Sudo-Guts/VoxID/DOC/CheckList.txt

==========================================================================
VOXID | Seguimiento de etapas
==========================================================================

[x] Confirmar plataforma digital: Ophyra, STM32F407VGT6 y TFT ST7735.
[x] Implementar DSP portable: Frame, Hamming, FFT, potencia, Mel, log-Mel y DCT.
[x] Integrar los ocho modulos compartidos sin duplicarlos en el firmware.
[x] Conservar el benchmark sintetico en voxid_test y sus dependencias.
[x] Implementar la autoprueba sintetica de 720 muestras y tres frames.
[x] Unificar parametros digitales en voxid_config.h.
[x] Normalizar el codigo propio: ASCII, cuatro espacios y firmas en una linea.
[x] Documentar APIs propias y conservar bloques USER CODE del firmware generado.
[x] Corregir recorte GFX con coordenadas negativas y probarlo sobre memoria.
[x] Corregir Makefile: dependencias DSP, seleccion de prueba y ejecucion completa.
[x] Excluir resultados generados de C0DE/out y conservar .gitkeep.

==========================================================================
ETAPA 1 | ADC1 + TIM2 + DMA e interfaz
==========================================================================

[x] Configurar PA2, ADC1 de 12 bits, TIM2 TRGO a 16 kHz y DMA circular.
[x] Capturar 48000 muestras en 75 mitades de 640 muestras.
[x] Mantener el procesamiento fuera de las interrupciones.
[x] Rechazar capturas con bloques sobrescritos o errores HAL.
[x] Detener ADC y DMA desde el bucle principal tambien tras un error de IRQ.
[x] Animar circulos solo en PREPARADO; fijarlos durante la captura.
[x] Corregir repeticion desde RESULTADO/ERROR y reiniciar cuenta regresiva.
[x] Mostrar solo BACK y bloquear UP/DN/OK desde la solicitud de captura.
[x] Probar el cambio entre tomas cuando ADC conserva READY de la anterior.
[x] Probar estos contratos en PC con HAL y dibujo simulados.
[ ] Clean/Build Debug con toolchain ARM en STM32CubeIDE.
[ ] Validar temporizacion, ADC, DMA, botones e interfaz en la placa.

==========================================================================
ETAPA 2 | PCM y MFCC de audio real
==========================================================================

[x] Convertir ADC sin signo a PCM de 16 bits y eliminar DC.
[x] Evitar el transitorio inicial de un nivel DC constante.
[x] Exigir 48000 muestras y 298 frames MFCC con coeficientes finitos.
[x] Separar frames totales de frames seleccionados por energia.
[x] Calcular la media solo con los frames seleccionados.
[x] No mostrar grafica de voz cuando no se seleccionaron frames.
[x] Probar silencio, offset DC, senal debil, tono e intermitencia en PC.
[x] Probar reinicio, cancelacion, fallos de ADC/DMA y repeticion.
[ ] Calibrar el umbral RMS con ruido y voz de la etapa analogica real.
[ ] Confirmar ausencia de perdida de bloques con DSP y TFT activos.
[ ] Verificar capturas repetibles de MARIPOSA en Ophyra.

==========================================================================
ETAPA 3 | Tres prototipos MFCC por locutor
==========================================================================

[x] Definir aceptacion inicial: continuidad, MFCC finitos y 20 frames seleccionados.
[x] Registrar tres medias MFCC de tomas independientes por locutor en RAM.
[x] Repetir tomas insuficientes o fallidas sin avanzar el contador.
[x] Conservar el perfil previo hasta aceptar tres tomas de reemplazo.
[x] Cancelar el registro pendiente sin borrar perfiles completos.
[x] Probar modulo de registro y flujo UI con ADC/DMA simulados.
[ ] Compilar la nueva version con toolchain ARM en STM32CubeIDE.
[ ] Validar registro, cancelacion y regrabacion en Ophyra.
[ ] Ajustar el minimo de frames con varias personas y nuevas tomas.

==========================================================================
ETAPA 4 | EEPROM M24C32 e identificacion
==========================================================================

[ ] Definir registros, version y validacion de perfiles.
[ ] Implementar acceso M24C32 y persistencia de prototipos.
[ ] Implementar distancia normalizada y criterio de rechazo.
[ ] Validar identificacion con tomas distintas de las usadas en registro.

==========================================================================
HARDWARE Y SIMULACIONES | Rama pcb-sim
==========================================================================

[ ] Integrar la revision de simulaciones con valores de la PCB vigente.
[ ] Ejecutar de nuevo AC, Monte Carlo y ruido con esos valores.
[ ] Verificar ERC/DRC y correspondencia de archivos de fabricacion.
[ ] Medir alimentaciones, offset y limites reales antes del acoplamiento ADC.
