Sudo-Guts/VoxID/PCB/Microfono.kicad_pcb

## KiCad design PCB/Microfono.kicad_pcb (2026-10-16)

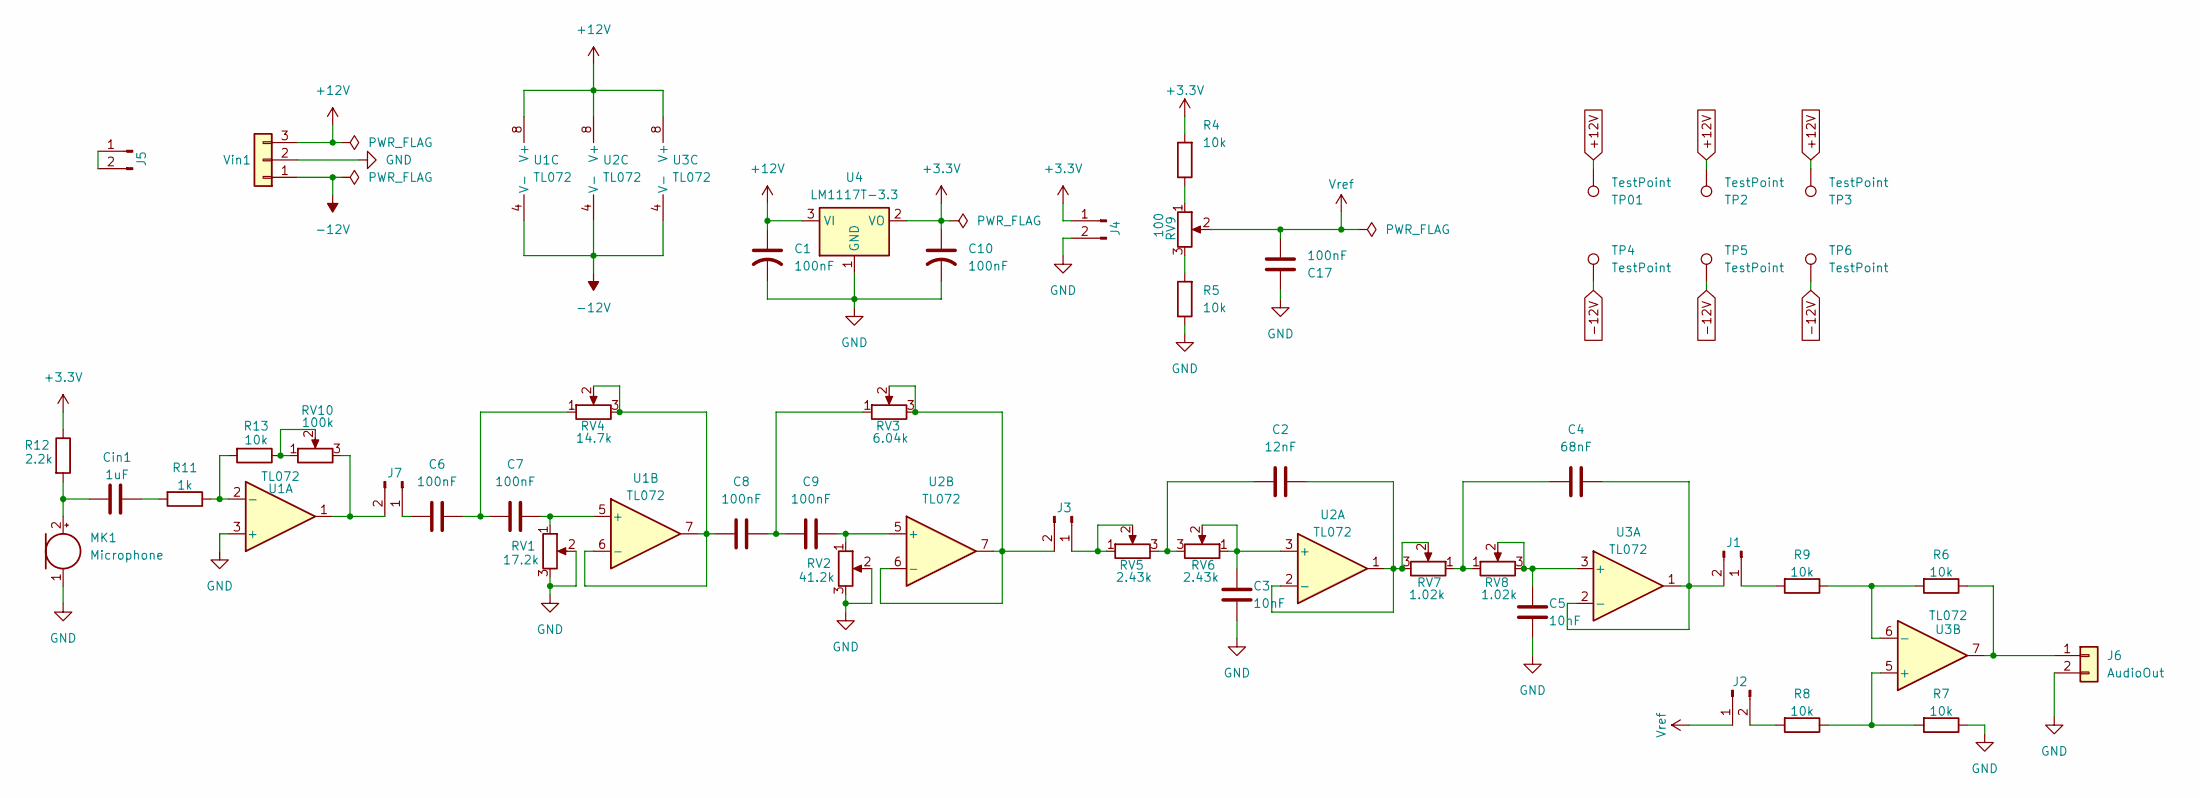
[picture p1: schematic Microfono.kicad_sch]

Parts:
C1, C6, C7, C8, C9, C10, C17: 100nF; CP_Radial_Tantal_D5.0mm_P5.00mm
C2: 12nF; CP_Radial_Tantal_D5.0mm_P5.00mm
C3, C5: 10nF; CP_Radial_Tantal_D5.0mm_P5.00mm
C4: 68nF; CP_Radial_Tantal_D5.0mm_P5.00mm
Cin1: 1uF; CP_Radial_Tantal_D5.0mm_P5.00mm
J1, J2, J3, J7: Conn_01x02_Pin; PinHeader_1x02_P2.54mm_Vertical
J4, J5: v3.3; PinHeader_1x02_P2.54mm_Vertical
J6: AudioOut; TerminalBlock_MaiXu_MX126-5.0-02P_1x02_P5.00mm
MK1: Microphone; POM-2244P-C3310-2-R
R4, R5, R6, R7, R8, R9, R13: 10k; R_Axial_DIN0309_L9.0mm_D3.2mm_P12.70mm_Horizontal
R11: 1k; R_Axial_DIN0309_L9.0mm_D3.2mm_P12.70mm_Horizontal
R12: 2.2k; R_Axial_DIN0309_L9.0mm_D3.2mm_P12.70mm_Horizontal
RV1: 17.2k; Potentiometer_Bourns_3296W_Vertical
RV2: 41.2k; Potentiometer_Bourns_3296W_Vertical
RV3: 6.04k; Potentiometer_Bourns_3296W_Vertical
RV4: 14.7k; Potentiometer_Bourns_3296W_Vertical
RV5, RV6: 2.43k; Potentiometer_Bourns_3296W_Vertical
RV7, RV8: 1.02k; Potentiometer_Bourns_3296W_Vertical
RV9: 100; Potentiometer_Bourns_3296W_Vertical
RV10: 100k; Potentiometer_Bourns_3296W_Vertical
TP01, TP2, TP3, TP4, TP5, TP6: TestPoint; TestPoint_Bridge_Pitch7.62mm_Drill1.3mm
U1, U2, U3: TL072; DIP-8_W7.62mm_Socket
U4: LM1117T-3.3; TO-220-3_Vertical
Vin1: Conn_01x03; TerminalBlock_MaiXu_MX126-5.0-03P_1x03_P5.00mm

Connections:
+3.3V: C10.1, J4.1 (Pin_1_1), R4.2, R12.1, U4.2 (VO)
+12V: C1.1, TP01.1 (1_1), TP2.1 (1_1), TP3.1 (1_1), U1.8 (V+), U2.8 (V+), U3.8 (V+), U4.3 (VI), Vin1.3
-12V: TP4.1 (1_1), TP5.1 (1_1), TP6.1 (1_1), U1.4 (V-), U2.4 (V-), U3.4 (V-), Vin1.1
unnamed: C2.1, RV5.3, RV6.3
unnamed: C4.1, RV7.1, RV8.1
unnamed: C6.2, C7.1, RV4.1
unnamed: C8.2, C9.1, RV3.1
unnamed: Cin1.2, R11.2
unnamed: J1.1, R9.2
unnamed: C4.2, J1.2, U3.1, U3.2 (-)
unnamed: J2.2, R8.2
unnamed: J3.1, RV5.1, RV5.2
unnamed: J3.2, RV3.2, RV3.3, U2.6 (-), U2.7
unnamed: J5.1, J5.2
unnamed: J6.1 (Pin_1_1), R6.1, U3.7
unnamed: C6.1, J7.1
unnamed: J7.2, RV10.3, U1.1
unnamed: Cin1.1, MK1.2 (+_2), R12.2
unnamed: R4.1, RV9.1
unnamed: R5.2, RV9.3
unnamed: R13.1, RV10.1, RV10.2
unnamed: R11.1, R13.2, U1.2 (-)
unnamed: C7.2, RV1.1 (1_1), U1.5 (+)
unnamed: C8.1, RV4.2, RV4.3, U1.6 (-), U1.7
unnamed: C3.1, RV6.1, RV6.2, U2.3 (+)
unnamed: C2.2, RV7.2, RV7.3, U2.1, U2.2 (-)
unnamed: C9.2, RV2.1 (1_1), U2.5 (+)
unnamed: C5.1, RV8.2, RV8.3, U3.3 (+)
unnamed: R7.2, R8.1, U3.5 (+)
unnamed: R6.2, R9.1, U3.6 (-)
Vref: C17.1, J2.1, RV9.2

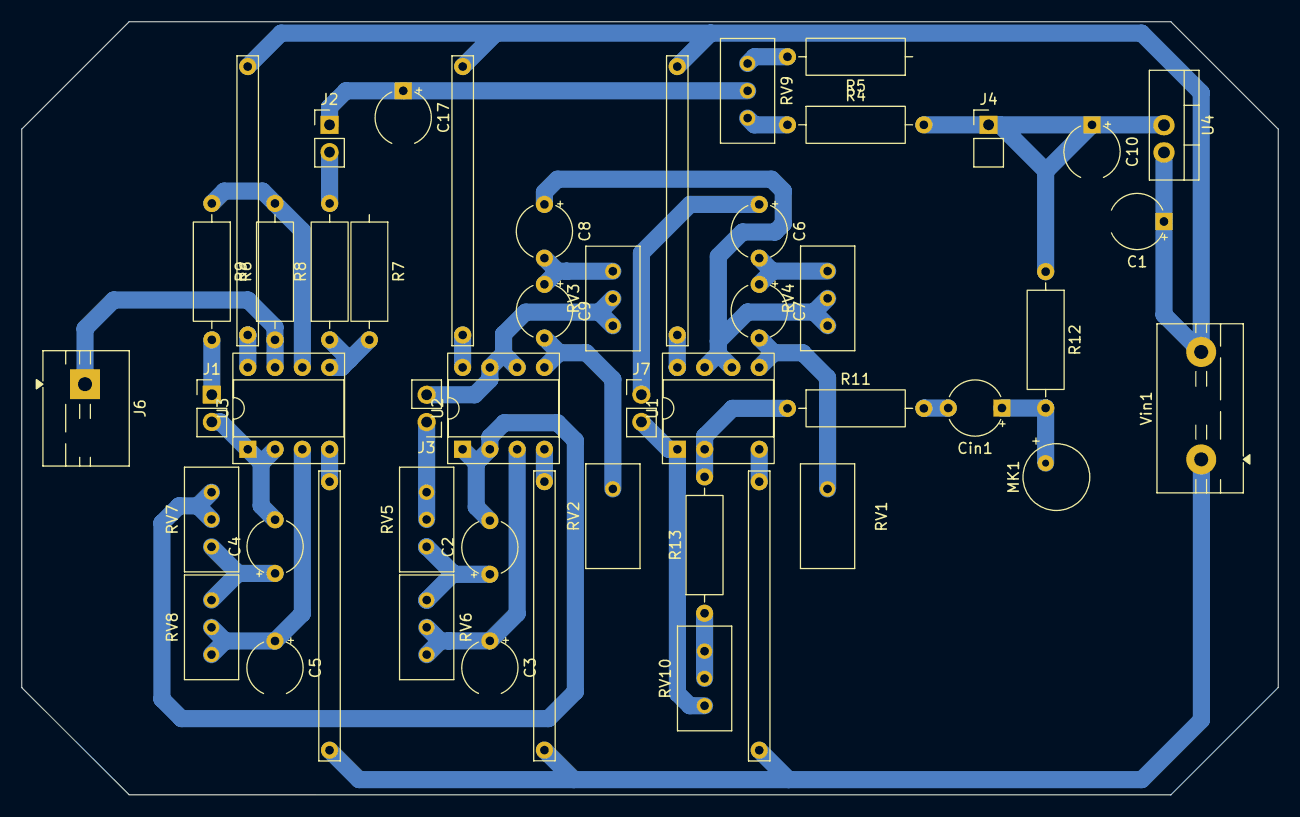
[picture p2: board Microfono.kicad_pcb from above]

Board: 2 copper layers, 117.0 x 72.0 mm, 49 parts (0 on the bottom side), 30 nets.
