Sudo-Guts/VoxID/C0DE/ophyra/voxid/Core/Src/main.c

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
/* Includes ------------------------------------------------------------------*/
#include "main.h"

/* USER CODE BEGIN Includes */
#include "st7735.h"
#include "buttons.h"
#include "ui.h"
#include "voxid_dsp.h"
#include "voxid_audio.h"
#include "voxid_storage.h"

/* USER CODE END Includes */

ADC_HandleTypeDef hadc1;
DMA_HandleTypeDef hdma_adc1;

I2C_HandleTypeDef hi2c1;

SPI_HandleTypeDef hspi1;

TIM_HandleTypeDef htim2;

/* USER CODE BEGIN PV */
static volatile bool ui_ready = false;
/* USER CODE END PV */

void SystemClock_Config(void);
static void MX_GPIO_Init(void);
static void MX_DMA_Init(void);
static void MX_ADC1_Init(void);
static void MX_I2C1_Init(void);
static void MX_SPI1_Init(void);
static void MX_TIM2_Init(void);
/**
  * @brief  The application entry point.
  * @retval int
  */
int main(void)
{

  /* MCU Configuration--------------------------------------------------------*/

  /* Reset of all peripherals, Initializes the Flash interface and the Systick. */
  HAL_Init();

  /* Configure the system clock */
  SystemClock_Config();

  /* Initialize all configured peripherals */
  MX_GPIO_Init();
  MX_DMA_Init();
  MX_ADC1_Init();
  MX_SPI1_Init();
  MX_TIM2_Init();
  MX_I2C1_Init();

  /* USER CODE BEGIN 2 */

  buttons_init();

  // Preparar el pipeline MFCC antes de capturar muestras reales.
  (void)voxid_dsp_init();

  // Cargar lo recuperable; LOCUTORES informa los fallos de lectura.
  (void)voxid_storage_init(&hi2c1);

  ui_ready = st7735_init(&hspi1);

  if (ui_ready) {
      ui_ready = ui_init();
  }

    /* USER CODE END 2 */

  /* Infinite loop */
  /* USER CODE BEGIN WHILE */
  while (1)
  {
    /* USER CODE END WHILE */

    /* USER CODE BEGIN 3 */

    if (ui_ready) {
        voxid_audio_task();
        ui_task();
        HAL_Delay(voxid_audio_status() == VOXID_AUDIO_CAPTURING ? 1U : 5U);
    } else {
        HAL_Delay(100U);
    }
  }
  /* USER CODE END 3 */
}

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
/* USER CODE BEGIN 4 */

void HAL_GPIO_EXTI_Callback(uint16_t GPIO_Pin)
{
    buttons_on_exti(GPIO_Pin, HAL_GetTick());
}


/* USER CODE END 4 */
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
