Sudo-Guts/VoxID/C0DE/ophyra/voxid/voxid.ioc

Mcu.UserName=STM32F407VGTx
PA15.GPIO_Label=SPI_CS
PA15.Signal=GPIO_Output
PA2.Signal=ADCx_IN2
PA7.GPIO_Label=TFT_BckLight
PA7.Signal=GPIO_Output
PB3.Signal=SPI1_SCK
PB5.Signal=SPI1_MOSI
PC2.GPIO_Label=BTN_UP
PC2.Signal=GPXTI2
PD3.GPIO_Label=BTN_BACK
PD3.Signal=GPXTI3
PD4.GPIO_Label=BTN_OK
PD4.Signal=GPXTI4
PD5.GPIO_Label=BTN_DOWN
PD5.Signal=GPXTI5
PD6.GPIO_Label=TFT_RS
PD6.Signal=GPIO_Output
PD7.GPIO_Label=TFT_Reset
PD7.Signal=GPIO_Output
PH0-OSC_IN.Signal=RCC_OSC_IN
PH1-OSC_OUT.Signal=RCC_OSC_OUT
