Sudo-Guts/VoxID/(commit log)

2026-10-18 build: Configurar compilacion inicial de VoxID en Windows
2026-10-19 build: Agregar sistema de pruebas generico y limpieza automatica
2026-10-19 feat: Implementar modulo de segmentacion de audio
2026-10-19 docs: Organizar avances y tareas pendientes de C0DE
2026-10-19 feat: Implementar modulo de enventanado de audio
2026-10-20 wip: Actualizacion de PCB y simulaciones
2026-10-20 sim: Organizar archivos de simulación PSIM y LTspice
2026-10-21 feat: Implementar FFT Radix-2 con factores de rotacion
2026-10-21 feat: Actualizar diseño PCB y agregar diagrama del sistema
2026-10-21 test: Agregar pruebas unitarias de FFT Radix-2
2026-10-22 pcb: Sustituir potenciometros por resistencias fijas comerciales
2026-10-22 feat: Implementar modulo de espectro de potencia
2026-10-22 feat: Implementar banco de filtros Mel
2026-10-22 feat: Implementar transformacion logaritmica de energias Mel
2026-10-22 feat: Integrar cadena de extraccion MFCC
2026-10-22 pcb: Incluir proteccion del ADC
2026-10-22 pcb: enrutado
2026-10-23 pcb: Creacion de geber para cnc
2026-10-23 pcb: Pcb lista :)
2026-10-23 chore(ophyra): Configurar ADC1 y TIM2 para muestreo a 16 kHz, y spi1 para la TFT
2026-10-23 feat(ophyra): Implementar eventos EXTI y antirrebote de botones
2026-10-23 feat(ophyra): Crear interfaz TFT horizontal con maquina de estados
2026-10-23 built: Creacion de proyecto voxid_test
2026-10-23 Integracion de codigo C
    built: Creacion del codigo C base, para el procesamiento de voz
2026-10-26 feat(tft): implementar controlador ST7735 con HAL SPI
2026-10-26 refactor(tft): unificar API gfx y normalizar estilo de librerias
2026-10-26 feat(gfx): Agregar implementacion de graficos en la TFT
2026-10-26 feat(ui): migrar interfaz Ophyra a gfx y retirar driver INTESC
2026-10-26 chore(tft): conservar archivo base de VoxID y limpiar preferencias IDE
2026-10-26 build(stm32): agregar ruta DSP compartida en Debug y Release
2026-10-26 style(ui): Actualizar interfaz grafica de VoxID
2026-10-26 feat(ui): agregar autoprueba MFCC y pantallas preparatorias de locutor
    Validar 720 muestras sinteticas, tres frames MFCC y coeficientes finitos desde Diagnostico. Preparar flujos de identificar y registrar sin afirmar adquisicion real.
2026-10-27 feat(ui): mini botones de navegacion y graficas de prueba MFCC
    Distribuir UP/DN/OK/BACK como indicadores de pulsadores fisicos y agregar vistas de forma de onda PCM y barras de 13 MFCC, conservando resumen y coeficientes numericos.
2026-10-27 style(ui): simplificar prueba MFCC y footer contextual
    Eliminar vista de onda sintetica y leyenda de signos, alinear campos del resumen en dos columnas y ocultar etiquetas de botones inactivos. Conservar grafica de MFCC y prueba numerica.
2026-10-27 feat(audio): habilitar captura corta ADC1 con disparos TIM2 a 16 kHz
    Agregar captura finita de 720 muestras mediante IRQ EOC, comprobaciones de min/max/promedio y control de inicio/parada desde la UI. Dejar DMA y PCM/MFCC de audio real para la siguiente fase.
2026-10-27 feat(ui): animar circulos concentricos pastel durante captura ADC
    Crear modulo grafico reutilizable ui_voice sin bloqueos, con tres anillos en fondo claro y redibujado acotado. Mantener estadisticas de ADC y preparar estados de voz futuros.
2026-10-27 feat(audio): capturar MARIPOSA durante 3s con ADC1 TIM2 DMA
    Configurar DMA2 Stream0 CH0 circular y solicitudes ADC continuas, consumir bloques de 640 muestras sin procesar en IRQ y detenerse tras 48000 muestras. Integrar cuenta regresiva con circulos pastel y verificacion de MIN MAX PROMEDIO; preservar MFCC sintetico.
2026-10-27 fix(audio): evitar detener DMA si ADC no tiene handle vinculado
    Validar configuracion antes de invocar HAL_ADC_Stop_DMA y proteger la salida al cancelar una captura con perifericos sin vincular.
2026-10-27 fix(ui): detener animacion en resultados y ocultar OK durante escucha
    Separar vistas PREPARADO, ESCUCHANDO y RESULTADO/ERROR; mantener BACK habilitado durante DMA, permitir OK solo antes/despues y limpiar el area de circulos al concluir captura.
2026-10-27 perf(ui): animar circulos solo antes de iniciar la captura
    Mantener fase fija durante ADC/DMA y actualizar solo cuenta regresiva; conservar circulos animados en PREPARADO y ocultarlos en RESULTADO/ERROR.
2026-10-27 feat(dsp): procesar PCM y MFCC reales desde ADC DMA en 3 s
    Agregar voxid_voice para conversion ADC->PCM con filtro DC, alimentar extractor MFCC en semibuffers y validar 298 frames finitos; detectar sobreescritura DMA durante DSP, mostrar resumen y grafica de media MFCC, preservar autoprueba sintetica y circulos estaticos al capturar.
2026-10-27 fix(voz): estabilizar etapas 1 y 2 y limpiar el codigo propio
    Corregir repeticion de captura, cierre de errores ADC/DMA y transitorio DC. Seleccionar frames por energia para la media MFCC y mostrar ausencia de voz. Corregir recorte GFX con coordenadas negativas, unificar parametros, documentar APIs y normalizar ASCII, sangria y firmas.
    Agregar regresiones de voz, audio, UI y GFX, corregir el Makefile y retirar binarios generados. Actualizar estado y procedimiento de validacion; etapas 3 y 4 pendientes.
2026-10-27 fix(sim): alinear netlists con los componentes comerciales de la PCB
    Actualizar Monte Carlo y ruido con los 16 valores RC del esquematico vigente y agregar ensayo AC/transitorio nominal. Distinguir resultados historicos y supuesto de conexion de las secciones en cascada.
    Agregar comprobador de correspondencia KiCad-SPICE, sin dependencias externas. Los analisis numericos deben ejecutarse de nuevo en el simulador.
2026-10-27 fix(ui): mostrar solo BACK durante captura y bloquear eventos pendientes
    Ocultar UP, DN y OK desde que se solicita la toma, aunque ADC todavia conserve READY. Ignorar sus eventos hasta completar la captura y comprobar repeticion, error y cola de botones con la UI real simulada.
2026-10-27 feat(registro): guardar tres prototipos MFCC por locutor en RAM
    Agregar banco estatico de cuatro locutores, tres vectores de 13 coeficientes por perfil y aceptacion de tomas completas con voz suficiente. Conservar el perfil previo hasta aceptar el reemplazo completo y descartar registros pendientes al cancelar.
    Integrar TOMA 1/3, 2/3 y 3/3 en la UI, reintentar silencio/error sin avanzar y aceptar cada toma con OK. Mantener solo BACK durante captura. Agregar pruebas de registro y flujo UI con DSP real y ADC/DMA simulados; actualizar documentacion. EEPROM e identificacion quedan para etapa 4.
2026-10-27 feat(ui): consultar referencias de cada locutor
2026-10-27 feat(sim): preparar grabaciones de MARIPOSA en MATLAB
    Agregar entrada main, configuracion central y preparacion de audio con seleccion de canal, recorte manual, retiro de media y remuestreo antialiasing. Exportar WAV, CSV y MAT en directorios independientes.
    Conservar las simulaciones analogicas y excluir grabaciones y resultados locales de Git. Incluir pruebas funcionales con WAV sinteticos; ejecucion MATLAB pendiente.
2026-10-27 feat(ui): separar seleccion de locutor y consulta de tomas
