Sudo-Guts/VoxID/(notices)

Notices in the files:
C0DE/ophyra/voxid/Core/Src/main.c:
Copyright (c) 2026 STMicroelectronics.
All rights reserved.
This software is licensed under terms that can be found in the LICENSE file
